eSpark-Backup/chrisanderson-tensiondevice/Deliverables/Renderings/3D-TopView.png

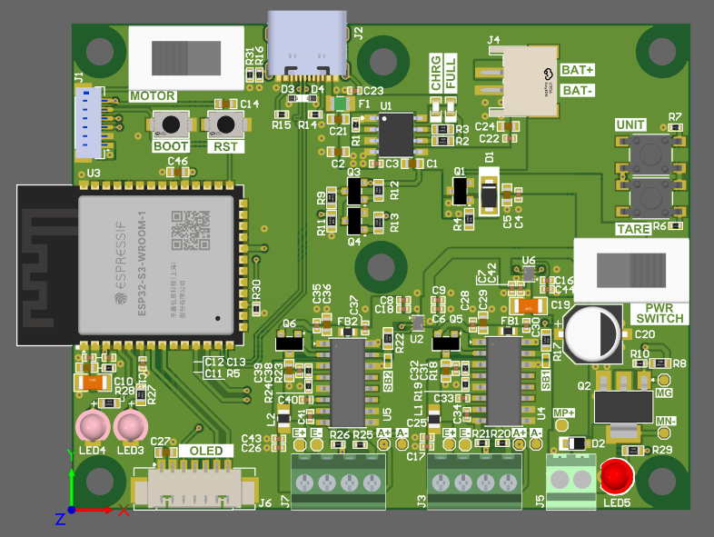
Deliverables/Renderings/3D-TopView.png
