eSpark-Backup/chrisanderson-tensiondevice/Deliverables/Renderings/Isometric.png

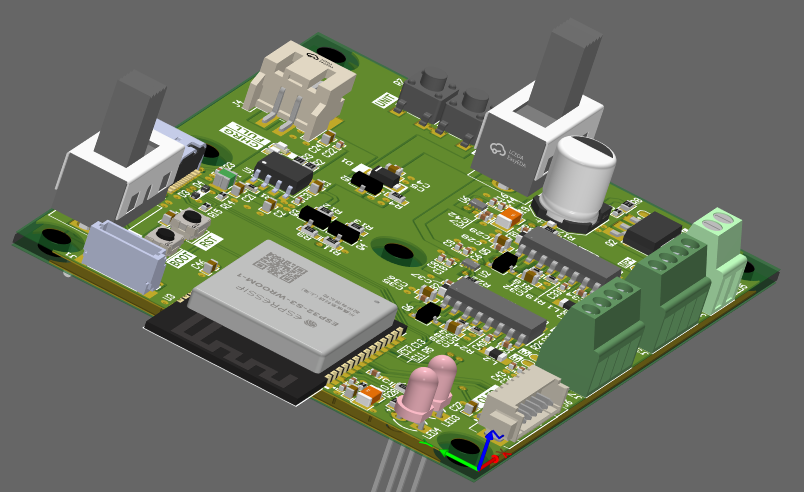
Deliverables/Renderings/Isometric.png
