eSpark-Backup/chrisanderson-tensiondevice/Deliverables/Renderings/2D-View.png

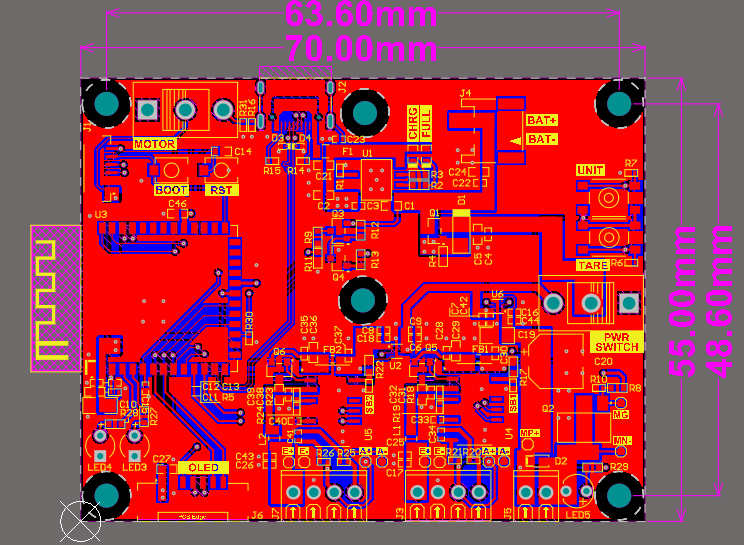
Deliverables/Renderings/2D-View.png
