eSpark-Backup/chrisanderson-tensiondevice/Deliverables/Renderings/3D-BottomView.png

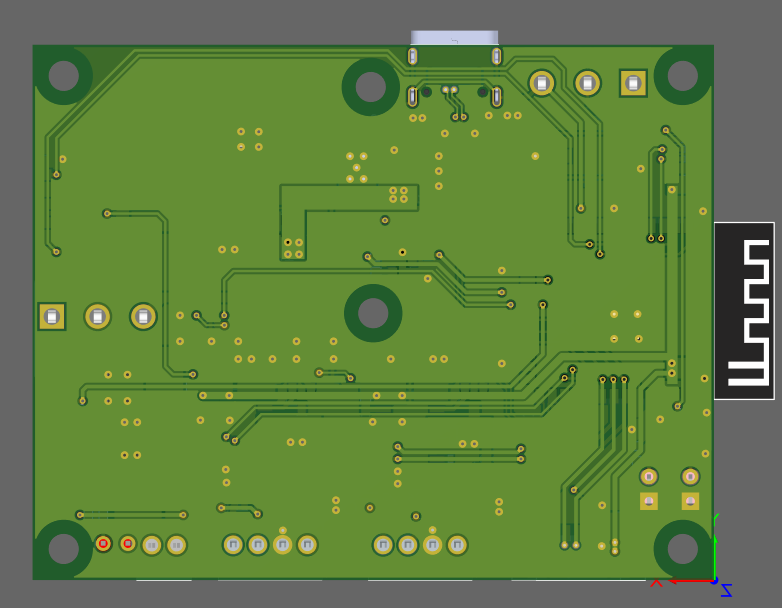
Deliverables/Renderings/3D-BottomView.png
