eSpark-Backup/chrisanderson-tensiondevice/Deliverables/BOM/Client BOM.xlsx

# | Item Type | Designator | Description | Footprint | Manufacturer Part Number | Manufacturer | Value | Quantity | Remarks
1 | Capacitor | C1, C2, C5, C21, C24, C27 | CAP CER 10UF 25V X5R 0603 | Cap-0603 | CL10A106MA8NRNC | Samsung | 10uF | 6
2 | Capacitor | C3, C12, C15, C22 | CAP CER 0.1UF 25V X5R 0402 | Cap-0402 | CC0402KRX5R8BB104 | Yageo | 100nF | 4
3 | Capacitor | C4 | CAP CER 0.1UF 50V X5R 0402 | Cap-0402 | C1005X5R1H104K050BB | TDK | 0.1uF | 1
4 | Capacitor | C6, C8, C42, C44 | CAP CER 2.2UF 25V X5R 0402 | Cap-0402 | GRM155R61E225KE11D | Murata | 2.2uF | 4
5 | Capacitor | C7, C9, C16, C18, C25, C43 | CAP CER 10UF 10V X5R 0402 | Cap-0402 | CC0402MRX5R6BB106 | Yageo | 10uF | 6
6 | Capacitor | C10, C19 | 10V 100uF X5R ±20% 1206 Multilayer Ceramic Capacitors MLCC - SMD/SMT ROHS | Cap-1206 | GRM31CR61A107ME05L | Murata | 100uF | 2
7 | Capacitor | C11 | CAP CER 22UF 10V X5R 0603 | Cap-0603 | CC0603MRX5R6BB226 | Yageo | 22uF | 1
8 | Capacitor | C13 | CAP CER 1UF 25V X5R 0402 | Cap-0402 | CC0402KRX5R8BB105 | Yageo | 1uF | 1
9 | Capacitor | C14, C46 | CAP CER 0.1UF 50V X5R 0603 | Cap-0603 | CC0603KRX5R9BB104 | Yageo | 100nF | 2
10 | Capacitor | C17, C26, C28, C30, C31, C33, C34, C35, C37, C38, C40, C41 | CAP CER 0.1UF 100V X5R 0402 | Cap-0402 | GRM155R62A104KE14D | Murata | 0.1uf | 12
11 | Capacitor | C20 | 470uF 10V 220mA@120Hz 450mΩ ±20% SMD,D6.3xL5.8mm Aluminum Electrolytic Capacitors - SMD ROHS | Custom | RVE1A471M0605 | Roqang | 470uF | 1
12 | Capacitor | C23 | CAP CER 4700PF 50V X7R 0402 | Cap-0402 | CC0402KRX7R9BB472 | Yageo | 4.7nF | 1
13 | Capacitor | C29, C32, C36, C39 | CAP CER 10UF 10V X5R 0603 | Cap-0603 | CC0603KRX5R6BB106 | Yageo | 10uF | 4
14 | Diode | D1 | SOD-123FL Schottky Barrier Diodes (SBD) ROHS | SOD-123FL | PMEG4030ER | Shikues | - | 1
15 | Diode | D2 | DIODE SCHOTTKY 40V 1A SOD323 | SOD-323 | B5819WS-TP | MDD | - | 1
16 | Diode | D3, D4 | TVS DIODE 5V 9.8V SOD923 | SOD-923. | ESD9L5.0ST5G | ON Semiconductor | - | 2
17 | Fuse | F1 | 6V 2A 50A 1W -40℃~+85℃ 4A 4mΩ 5s 45mΩ 0805 Resettable Fuses ROHS | Fuse-0805 | BSMD0805L-200 | BHFUSE | - | 1
18 | Ferrite Bead | FB1, FB2 | FERRITE BEAD 120 OHM 0603 1LN | IND-0603 (1608 Metric) | BLM18SG121TN1D | Murata | - | 2
19 | Connector | J1 | 1x6P SH 1 1mm 6 SMD,P=1mm Wire To Board / Wire To Wire Connector ROHS | Custom | C145963 | BOOMELE | - | 1
20 | USB Connector | J2 | 5A 1 16P Female Type-C SMD USB Connectors ROHS | Custom | TYPE-C-31-M-12 | Korean Hroparts Elec | - | 1
21 | Screw Terminal | J3, J7 | 1x4P 6A -40℃~+105℃ 150V Green 18~24 Direct Insert 2.54mm 1 1 4 Plugin,P=2.54mm Screw Terminal Blocks ROHS | Custom | MX128-2.54-04P-GN01-Cu-Y-A | MAX | - | 2
22 | Connectors | J4 | CONN HEADER SMD R/A 2POS 2MM | Custom | S2B-PH-SM4-TB(LF)(SN) | JST | - | 1
23 | Screw Terminal | J5 | 1x2P 6A -40℃~+105℃ 150V Green 18~24 Direct Insert 2.54mm 1 1 2 Plugin,P=2.54mm Screw Terminal Blocks ROHS | Custom | MX128-2.54-02P-GN01-Cu-Y-A | MAX | - | 1
24 | Wire to Board Connector | J6 | SMD,P=1.25mm,Surface Mount，Right Angle | Custom | 1.25-7PWT | FG | - | 1
25 | Inductor | L1, L2 | 800mA 3.3uH ±20% 0805 Power Inductors ROHS | Ind-0805 | CMH201209B3R3MT | FH (Guangdong Fenghua Advanced Tech) | 3.3uH | 2
26 | LED | LED1 | RED LED 0603 Light Emitting Diodes | LED-0603 | NCD0603R3 | Foshan NationStar Optoelectronics | - | 1
27 | LED | LED2 | Emerald 0603 Light Emitting Diodes (LED) ROHS | LED-0603 | NCD0603G2 | Foshan NationStar Optoelectronics | - | 1
28 | LED | LED3 | 515nm~525nm -30℃~+85℃ Emerald 30° 200mW Plugin,D=3mm Light Emitting Diodes (LED) ROHS | TH LED 3mm_ | NFD3401UGD | Foshan NationStar Optoelectronics | - | 1
29 | LED | LED4 | 20mA -40℃~+80℃ 605nm Amber Color 50° 3mm圆形灯头 75mW Plugin,D=3mm Light Emitting Diodes (LED) ROHS | TH LED 3mm_ | LTL17KFL5D-012A | Lite-On | - | 1
30 | LED | LED5 | 620nm~630nm -30℃~+85℃ Red 30° 200mW Plugin,D=3mm Light Emitting Diodes (LED) ROHS | TH LED Red 3MM | NFD3401URD | Foshan NationStar Optoelectronics | - | 1
31 | Mosfet | Q1 | 30V 7A 19mΩ 1.9W 1.1V@250uA P Channel SOT-23-3L MOSFETs ROHS | SOT-23-3L_ | G7P03L | GoFord | - | 1
32 | MOSFETs | Q2 | MOSFET N-CH 55V 12A SOT223 | SOT- 223 | BUK9832-55A/CUX | Nexperia | - | 1
33 | Mosfet | Q3 | 30V 4.1A 60mΩ@10V,4.1A 350mW 3V@250uA P Channel SOT-23 MOSFETs ROHS | SOT-23 | AO3407 | Guangdong Hottech | - | 1
34 | Mosfet | Q4 | TRANS NPN 40V 0.6A SMD SOT23-3 | SOT-23 | MMBT2222A-7-F | Diodes | - | 1
35 | Mosfet | Q5, Q6 | TRANS PNP 40V 600MA SOT23-3 | sot-23 | MMBT4403LT1G | ON Semiconductor | - | 2
36 | Resistor | R1 | RES 1.2K OHM 1% 1/16W 0402 | Res-0402 | RC0402FR-071K2L | Yageo | 1.2K | 1
37 | Resistor | R2, R3 | RES SMD 330R 100 mW 0603 | Res-0603 | RC0603JR-07330RL | Yageo | 330R | 2
38 | Resistor | R4 | RES 100K OHM 5% 1/10W 0603 | Res-0603 | RC0603JR-07100KL | Yageo | 100K | 1
39 | Resistor | R5, R10 | RES SMD 10K OHM 0.5% 1/16W 0402 | Res-0402 | RE0402DRE0710KL | Yageo | 10K | 2
40 | Resistor | R6, R7, R14, R15, R30, R31 | RES 5.1K OHM 1% 1/16W 0402 | Res-0402 | RC0402FR-075K1L | Yageo | 5.1K | 6
41 | Resistor | R8 | RES SMD 100 OHM 1% 1/4W 0603 | RES-0603 | RCA0603100RFKEAHP | Vishay Dale | 100R | 1
42 | Resistor | R9 | RES SMD 100K OHM 0.1% 1/10W 0603 | Res-0603 | RT0603BRD07100KL | Yageo | 100K | 1
43 | Resistor | R11 | RES 270K OHM 0.5% 1/10W 0603 | Res-0603 | RC0603DR-07270KL | Yageo | 270K | 1
44 | Resistor | R12, R13 | RES SMD 1K OHM 1% 1/10W 0603 | Res-0603 | RC0603FR-071KL | Yageo | 1K | 2
45 | Resistor | R16 | Res Thick Film 0402 1M Ohm 1% 0.1W(1/10W) ±100ppm/C Pad SMD Automotive T/R | Res-0402 | RK73H1ETTP1004F | KOA Speer | 1M | 1
46 | Resistor | R17, R22 | RES SMD 10K Ohm 1% 1/10W 0603 | Res-0603 | RC0603FR-0710KL | Yageo | 10K | 2
47 | Resistor | R18, R23 | RES SMD 20K OHM 0.1% 1/16W 0402 | Res-0402 | RT0402BRD0720KL | Yageo | 20K | 2
48 | Resistor | R19, R24 | RES SMD 8.2K OHM 0.1% 1/16W 0402 | Res-0402 | RT0402BRD078K2L | Yageo | 8.2K | 2
49 | Resistor | R20, R21, R25, R26 | RES 100 OHM 1% 1/16W 0402 | Res-0402 | RC0402FR-07100RL | Yageo | 100R | 4
50 | Resistor | R27, R28, R29 | RES 130 OHM 1% 1/10W 0603 | Res-0603 | RC0603FR-07130RL | Yageo | 130R | 3
51 | Switch | SW1, SW6 | 3A Direct Insert Single Pole Double Throw (SPDT) 125V Black 10,000 times Plugin Slide Switches ROHS | Custom |  | XKB Connectivity | - | 2
52 | Tactile Switch | SW2, SW3 | Without bracket 50mA 4mm 100000 Times 12V 160gf 3mm 2mm Round Button Standing paste SPST SMD Tactile Switches ROHS | Custom | TS-1088-AR02016 | XUNPU | - | 2
53 | Switch | SW4, SW5 | No NO 50mA 4.5mm 100000 260gf 12V -30℃~+85℃ 4.5mm 4.3mm Black Round Button Brick nogging SPST SMD Tactile Switches ROHS | Custom | TS-1109S-C-B | XKB Connectivity | - | 2
54 | IC | U1 | ESOP-8 Battery Management ICs ROHS | ESOP-8 | TP4056-42-ESOP8 | TOPPOWER | - | 1
55 | IC | U2, U6 | IC REG LINEAR 3.3V 1A 8DFN | DFN-8(1.2x1.6) | LD56100DPU33R | STMicroelectronics | - | 2
56 | Module | U3 | SMD MODULE, ESP32-S3R8 WITH 3.3V | 41-SMD Module | ESP32-S3-WROOM-1-N16R8 | Espressif Systems | - | 1
57 | IC | U4, U5 | 2.7V~5.5V 24Bit SOP-16 Analog to Digital Converters (ADC) ROHS | SOP-16 | HX711 | Avia Semicon (Xiamen) | - | 2
58 | Peripheral | - | 3v 101 RPM motor | - | DC Motor | - | - | 1 | Aliexpress (https://vi.aliexpress.com/item/1005006213184701.html?gatewayAdapt=4itemAdapt)
59 | Peripheral | - | 500gm Load cell without HX711 load cell IC module | - | Load Cell | - | - | 1 | Aliexpress (https://vi.aliexpress.com/item/1005006024363708.html)
60 | Peripheral | - | 2.42 inch White OLED | - | LED Module | - | - | 1 | Alibaba (https://www.alibaba.com/product-detail/Waveshare-2-42inch-OLED-Display-Module_1600969512051.html)
61 | Peripheral | - | 7 Pin 10cm Reverse Side Double head inter-connection cable | - | JST Cable | - | - | 1 | Aliexpress (https://vi.aliexpress.com/item/1005006120886981.html)
