eSpark-Backup/chrisanderson-tensiondevice/Deliverables/Supporting File/Thread Tension Gauge .step

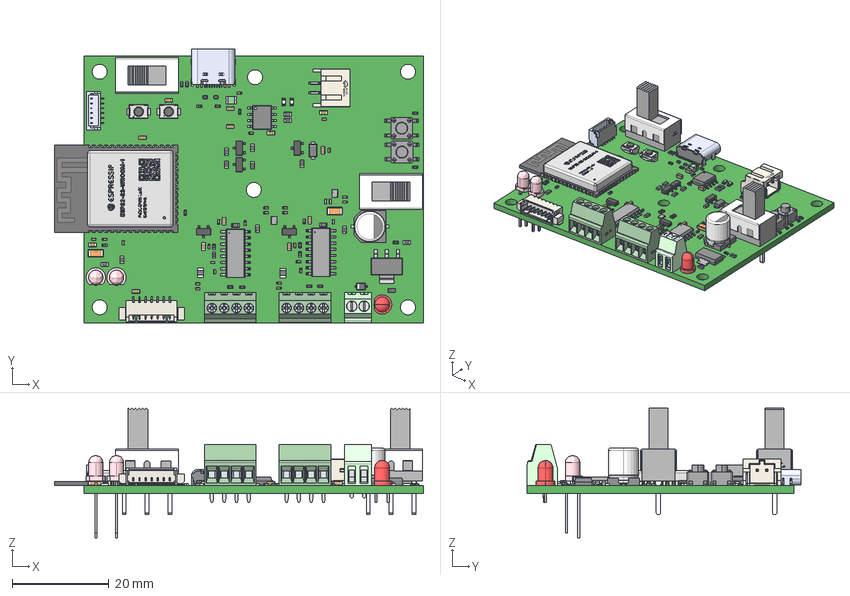
[picture p5: CAD file, 2025-05-21]
Deliverables/Supporting File/Thread Tension Gauge .step
76.1 x 56.5 x 26.8 mm
User Library-RESC1608X05N x 13
User Library-1206 SMD Capacitor x 2
User Library-DIODE_SOD-923 x 2
User Library-CAPC1608X09 x 13
User Library-SOD323-1
User Library-RES_1005-0402 x 18
User Library-Capacitor 0402 x 29
SO_18HDTR_STM x 2
ESP-S3-WROOM_via v3 x 26
ESP32-S3-WROOM_shell v11
ESP32-S3-WROOM_body v12
ESP-S3-WROOM_via v3(镜像) x 14
TP4056-42-ESOP8--3DModel-STEP-56544
ts-1109s-c-b_RGB6710886 x 2
CircuitWorks-SOT-23 x 5
User Library-SOT-223-1
User Library-LED 3 mm x 2
User Library-LED SMD0603 x 2
TYPE-C-31-M-12
SOLID.step.STEP.dwg.STEP.STEP.dwg
Lötende x 4
base x 2
User Library-fuse0805L050WR
User Library-SOD-123FL CASE 498
