eSpark-Backup/chrisanderson-tensiondevice/(list of files, cad)

Other CAD files:
Deliverables/Supporting File/Thread Tension Gauge .DWG
Deliverables/Supporting File/Thread Tension Gauge .DXF
