eSpark-Backup/chrisanderson-tensiondevice/Deliverables/Assembly Drawing/Thread Tension Gauge.pdf

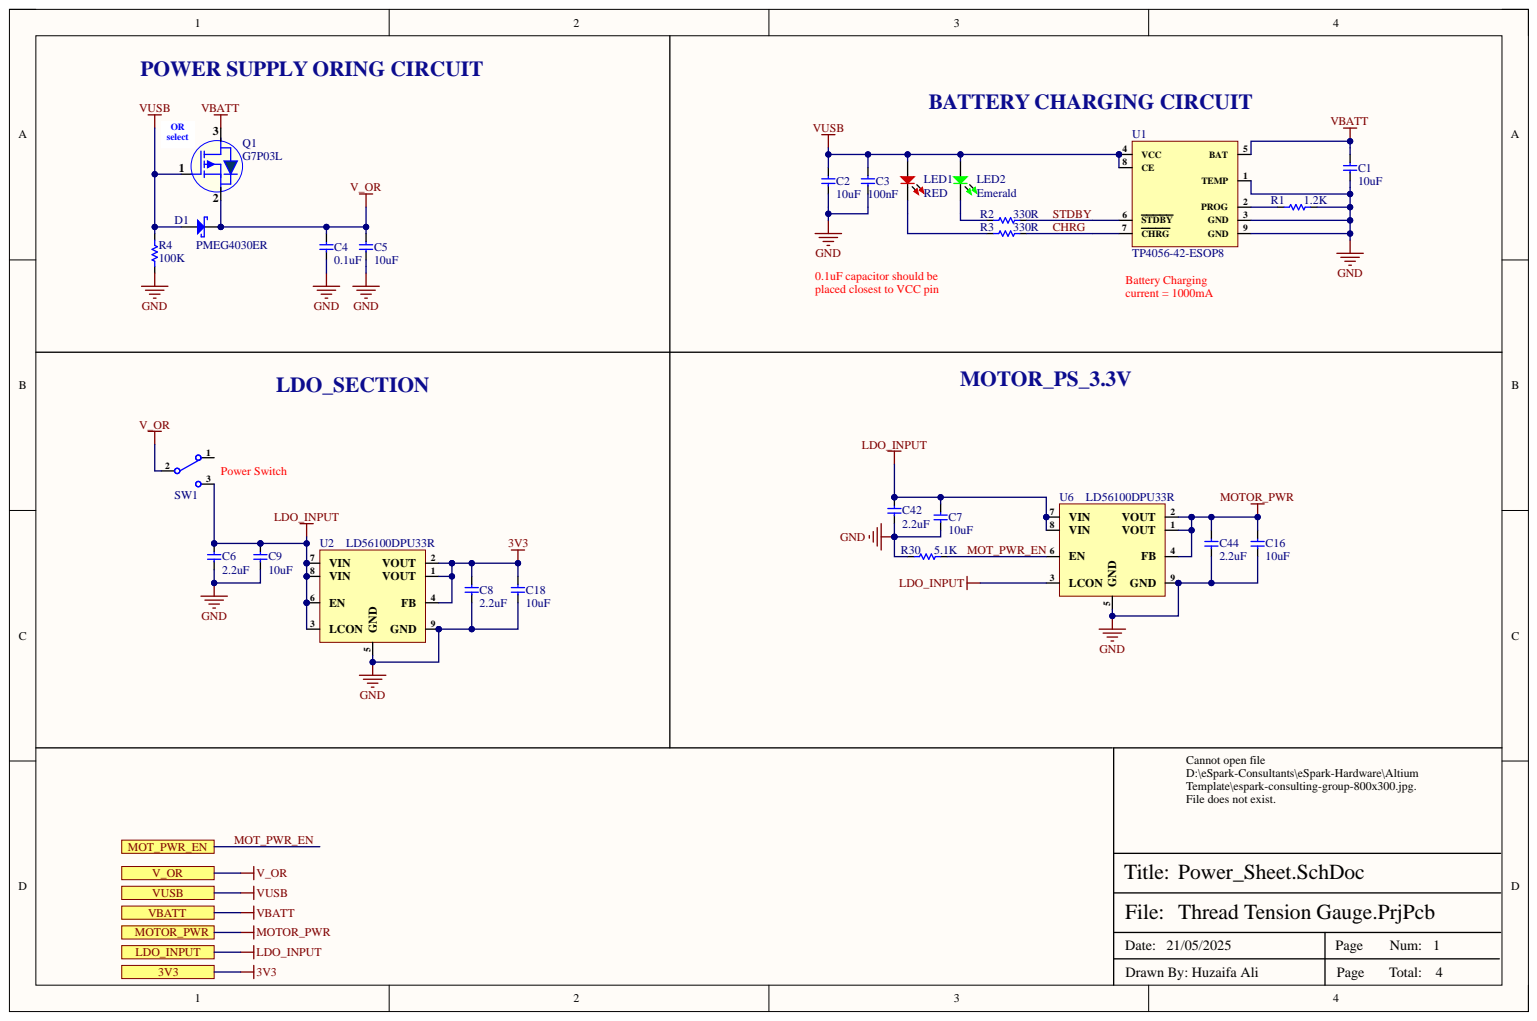
[picture p6: page 1]

POWER SUPPLY ORING CIRCUIT

0.1uF capacitor should be
placed closest to VCC pin

Cannot open file
D:\eSpark-Consultants\eSpark-Hardware\Altium
Template\espark-consulting-group-800x300.jpg.
File does not exist.

Thread Tension Gauge.PrjPcb

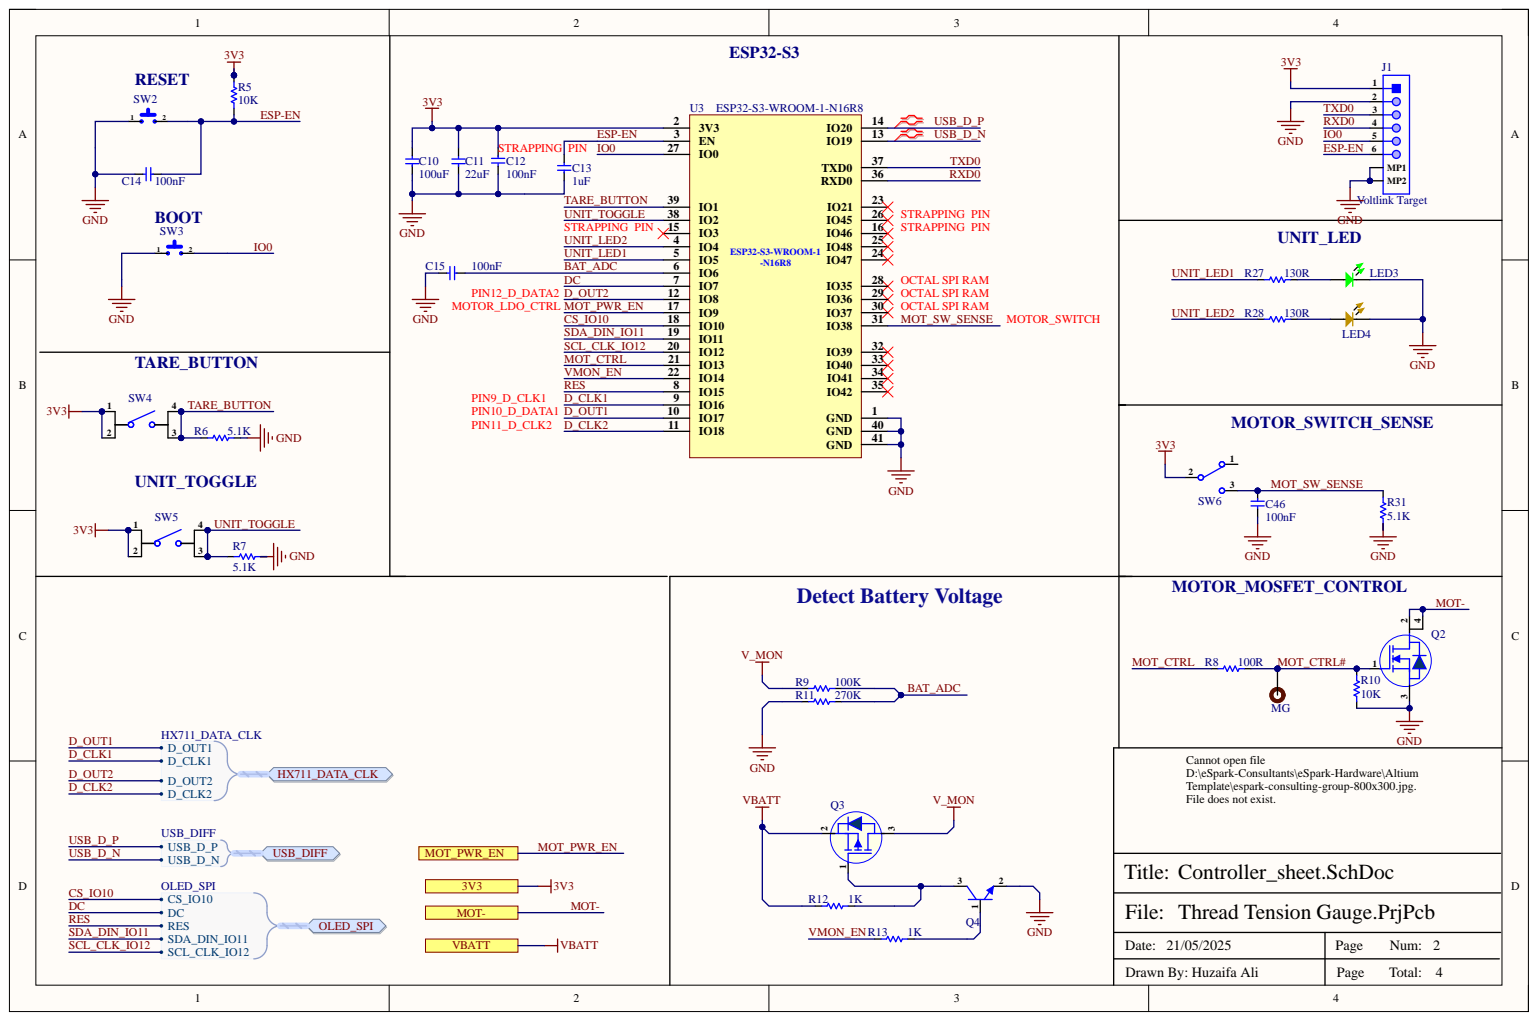
[picture p7: page 2]
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

Thread Tension Gauge.PrjPcb

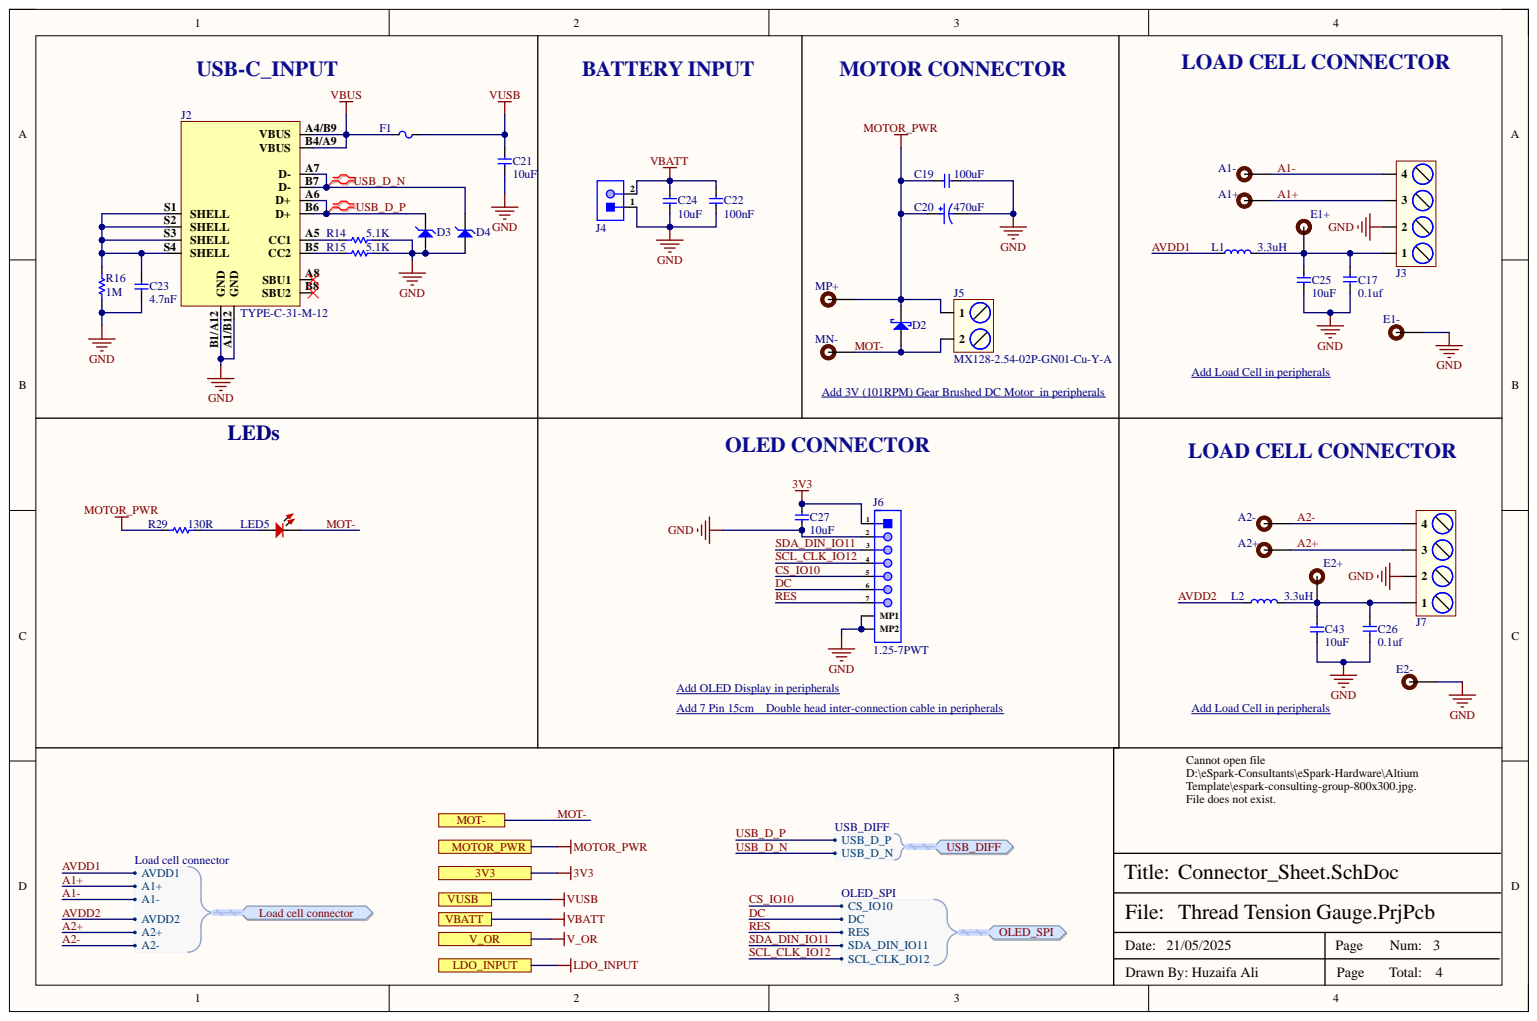
[picture p8: page 3]

Add Load Cell in peripherals

Add 3V (101RPM) Gear Brushed DC Motor in peripherals (https://vi.aliexpress.com/item/3256806026869949.html?gatewayAdapt=4itemAdapt)

Add OLED Display in peripherals (https://vi.aliexpress.com/item/3256805672655223.html?gatewayAdapt=glo2vnm4itemAdapt)
Add 7 Pin 15cm Double head inter-connection cable in peripherals (https://vi.aliexpress.com/i/2255800979562577.html?gatewayAdapt=glo2vnm4itemAdapt)

Add Load Cell in peripherals (https://vi.aliexpress.com/item/3256805838048956.html)

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

Thread Tension Gauge.PrjPcb

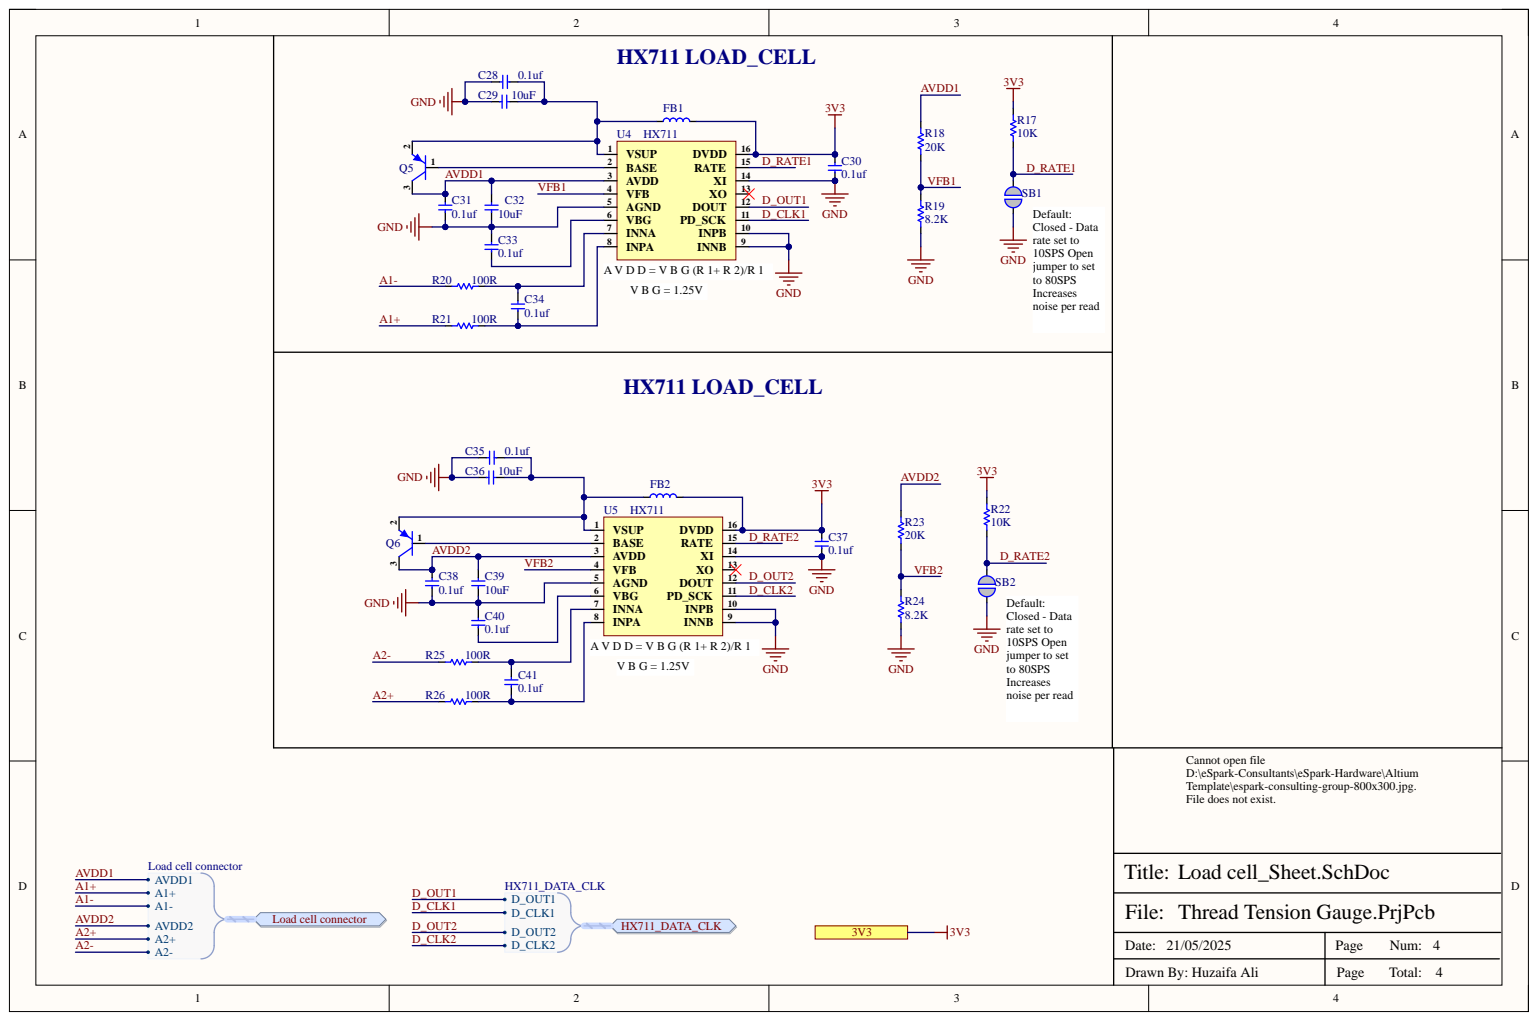
[picture p9: page 4]

C33
0.1uf

VFB2

C39
10uF

C40

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

Thread Tension Gauge.PrjPcb
