eSpark-Backup/chrisanderson-tensiondevice/Design Files/Tension Device/Schematic/Thread Tension Gauge.pdf

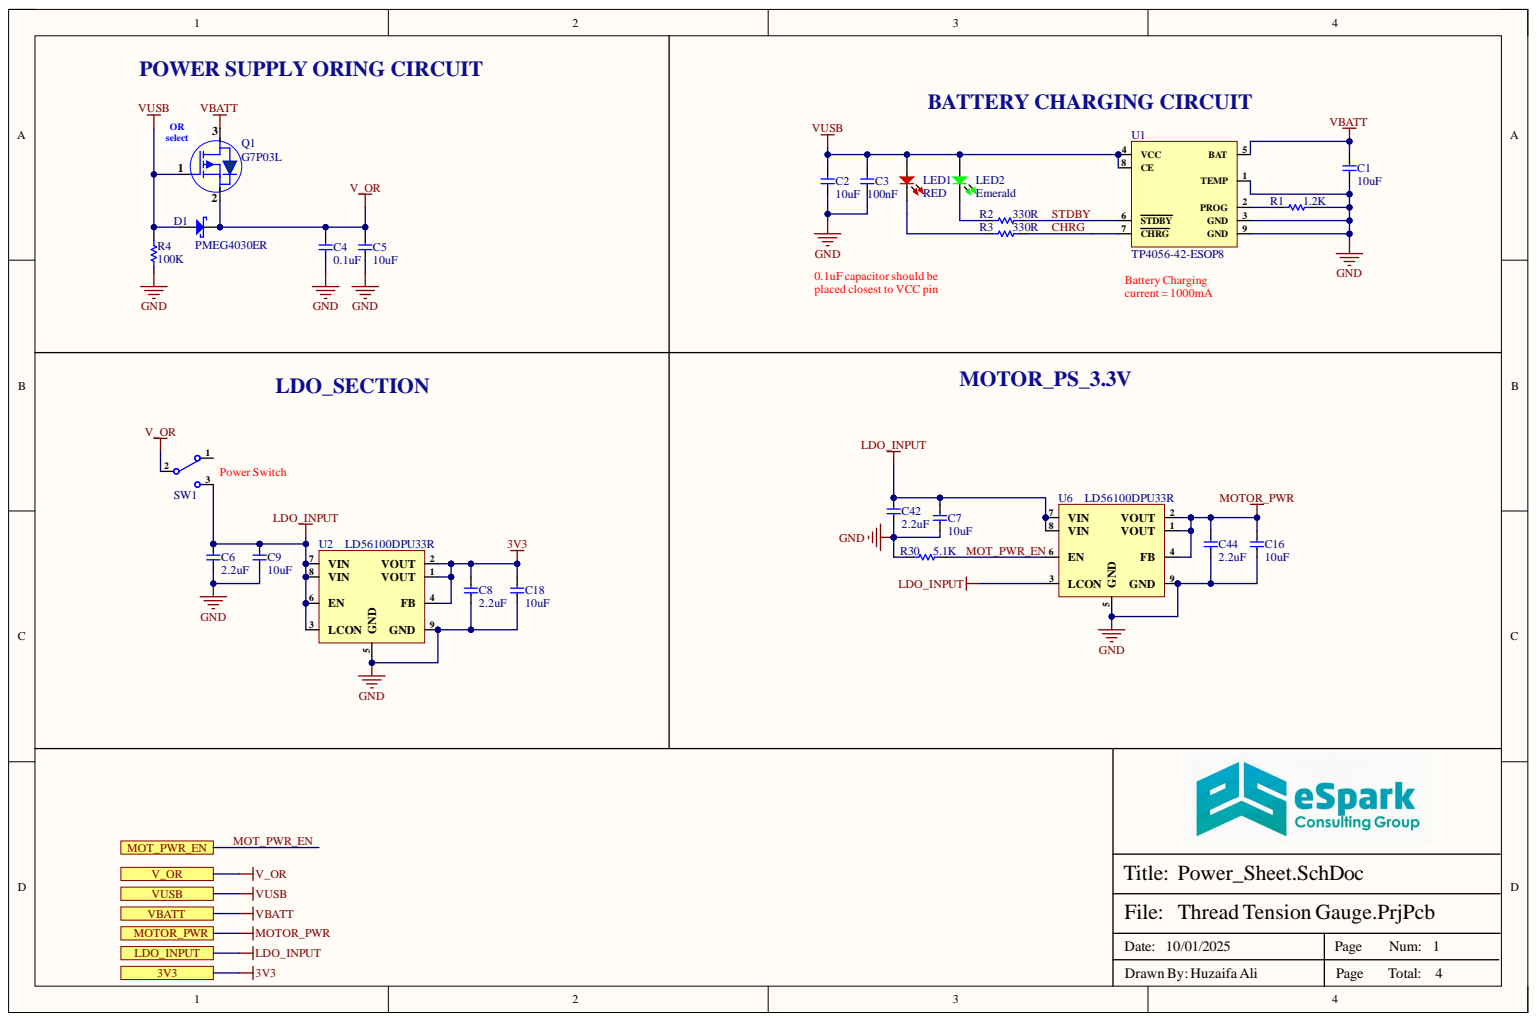
[picture p10: page 1]

POWER SUPPLY ORING CIRCUIT

0.1uF capacitor should be
placed closest to VCC pin

Thread Tension Gauge.PrjPcb

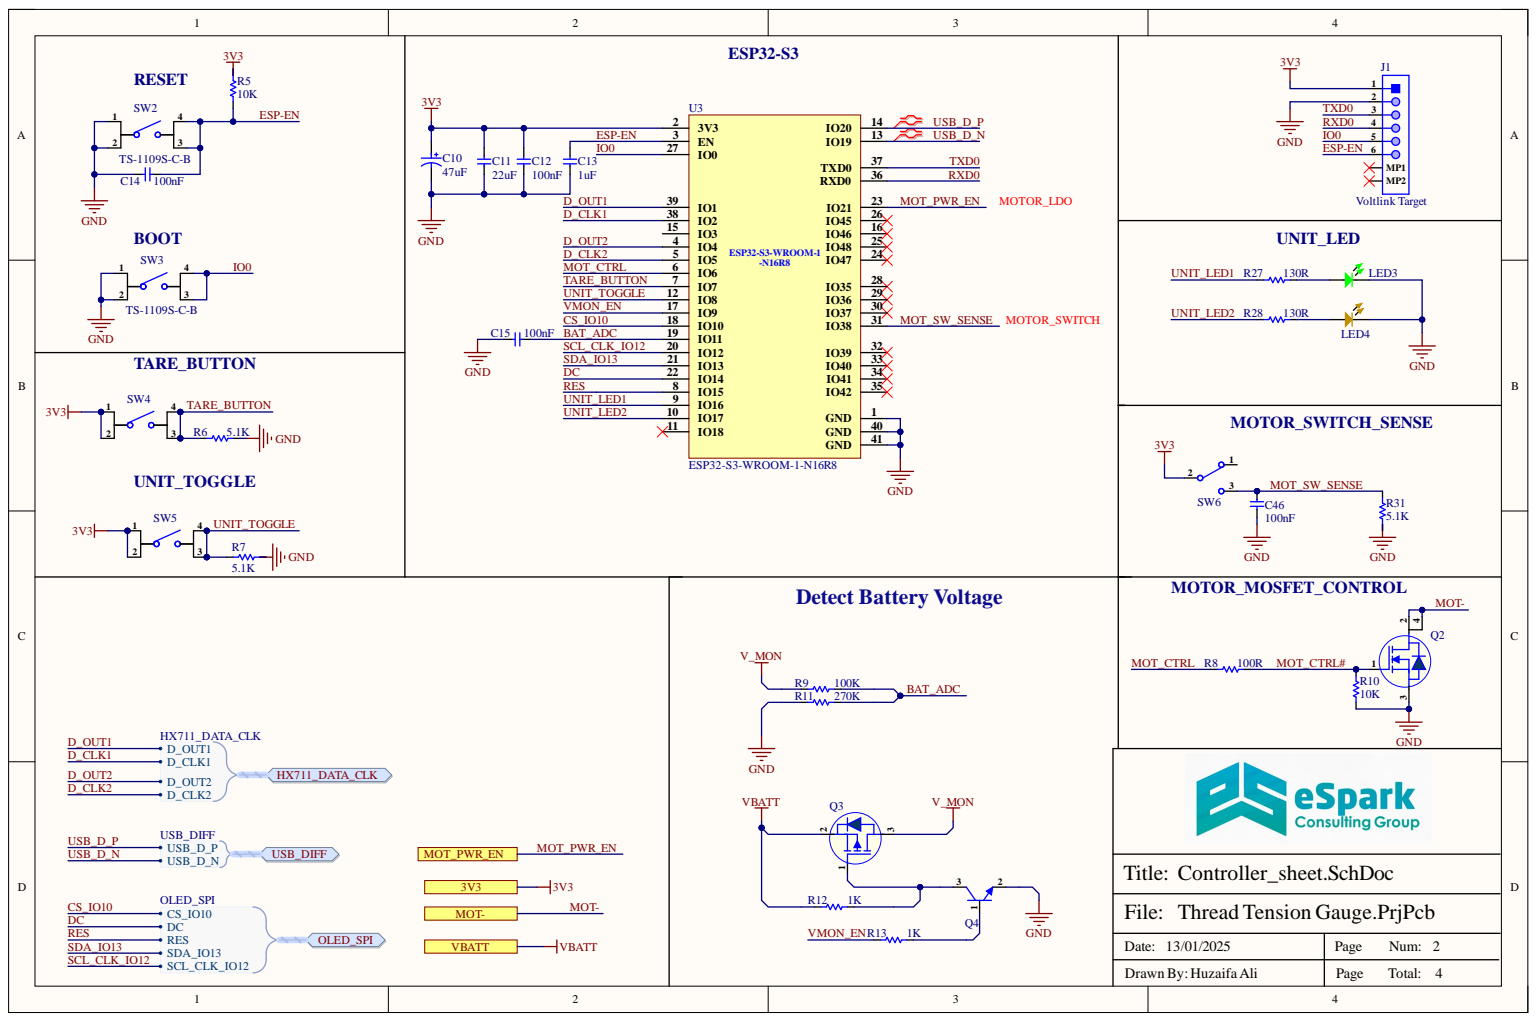
[picture p11: page 2]

Thread Tension Gauge.PrjPcb

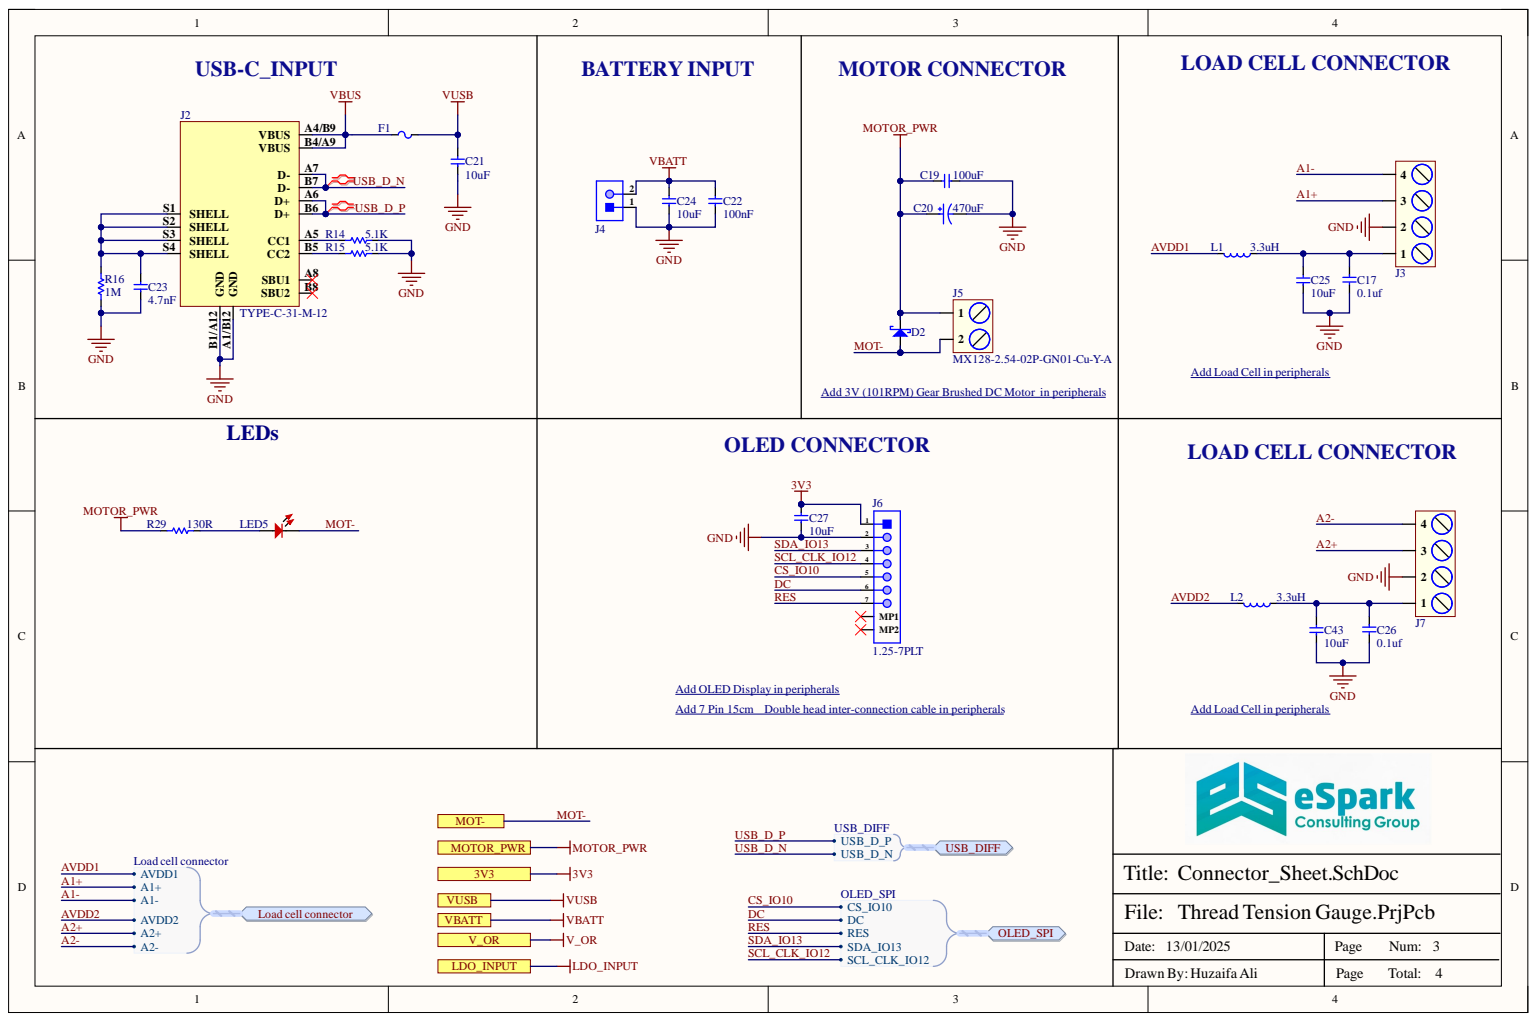
[picture p12: page 3]

Add Load Cell in peripherals

Add 3V (101RPM) Gear Brushed DC Motor in peripherals (https://vi.aliexpress.com/item/3256806026869949.html?gatewayAdapt=4itemAdapt)

Add OLED Display in peripherals (https://vi.aliexpress.com/item/3256805672655223.html?gatewayAdapt=glo2vnm4itemAdapt)
Add 7 Pin 15cm Double head inter-connection cable in peripherals (https://vi.aliexpress.com/i/2255800979562577.html?gatewayAdapt=glo2vnm4itemAdapt)

Add Load Cell in peripherals (https://vi.aliexpress.com/item/3256805838048956.html)

Thread Tension Gauge.PrjPcb

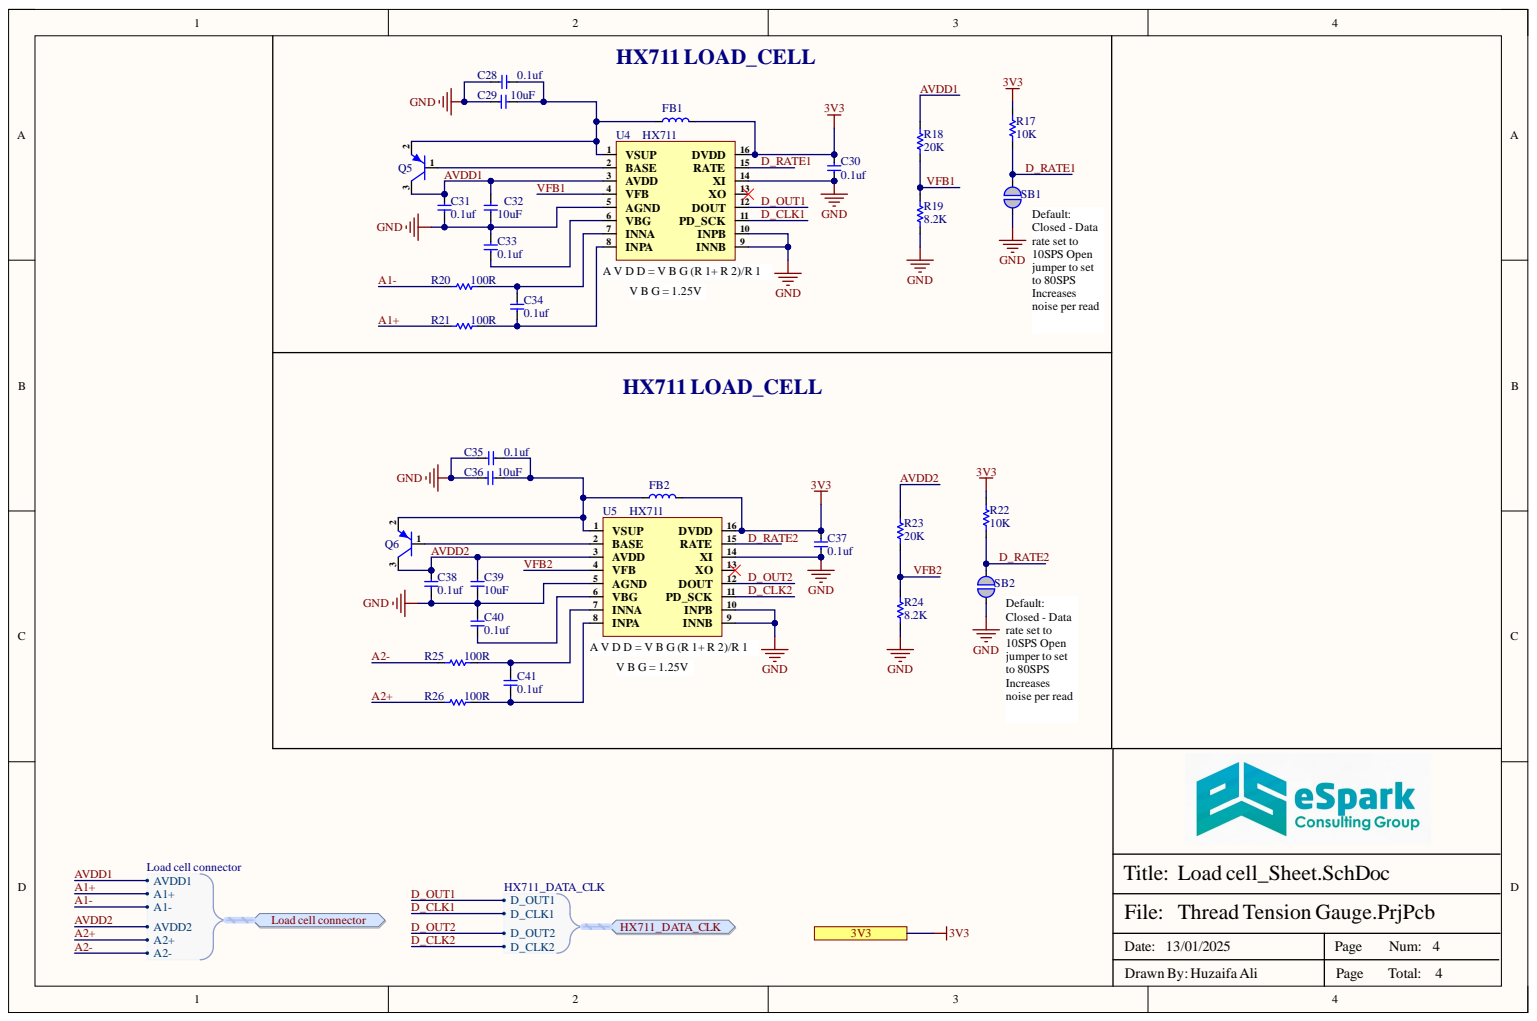
[picture p13: page 4]

C33
0.1uf

C40

Thread Tension Gauge.PrjPcb
