eSpark-Backup/chrisanderson-tensiondevice/Deliverables/Assembly Drawing/Assembly Drawing.pdf

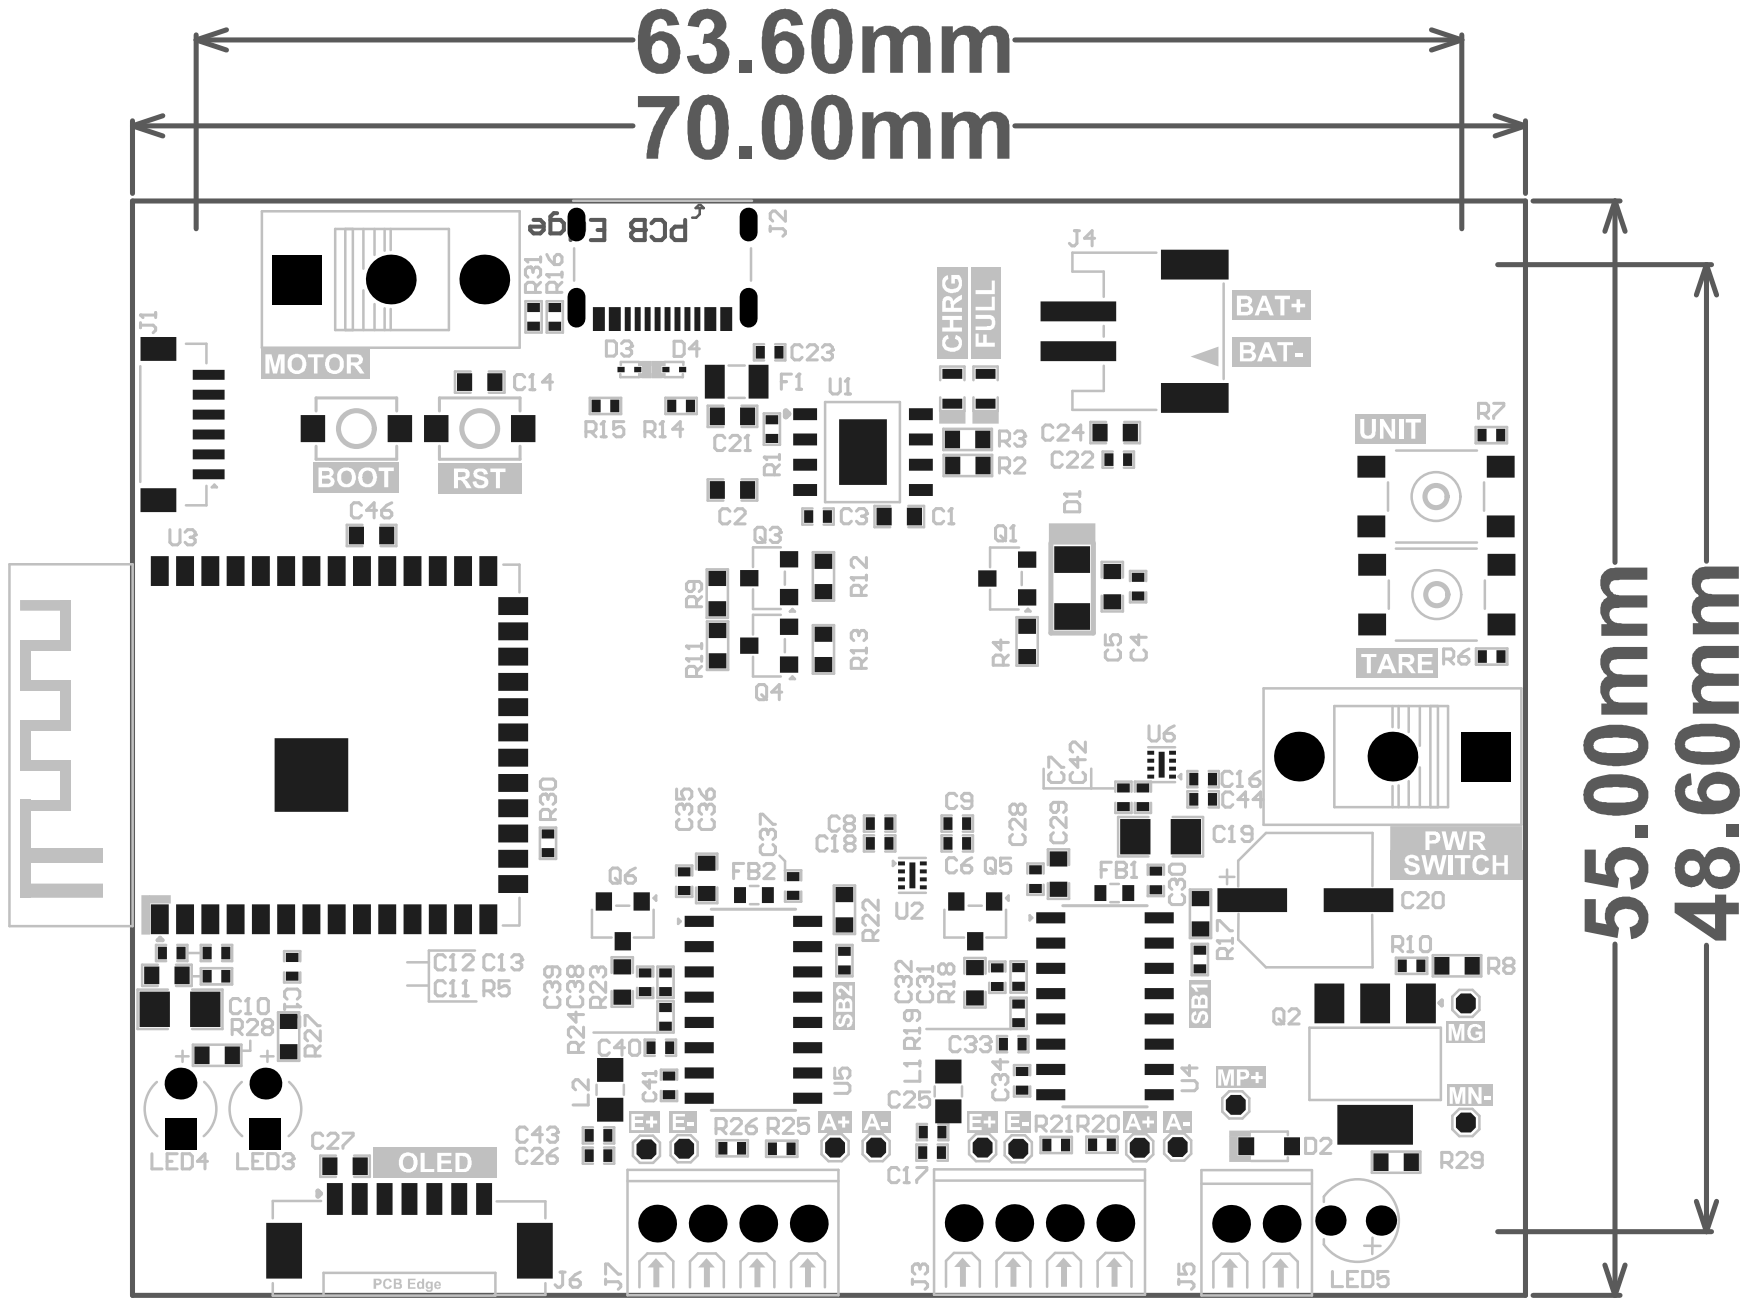
[picture p14: page 1]

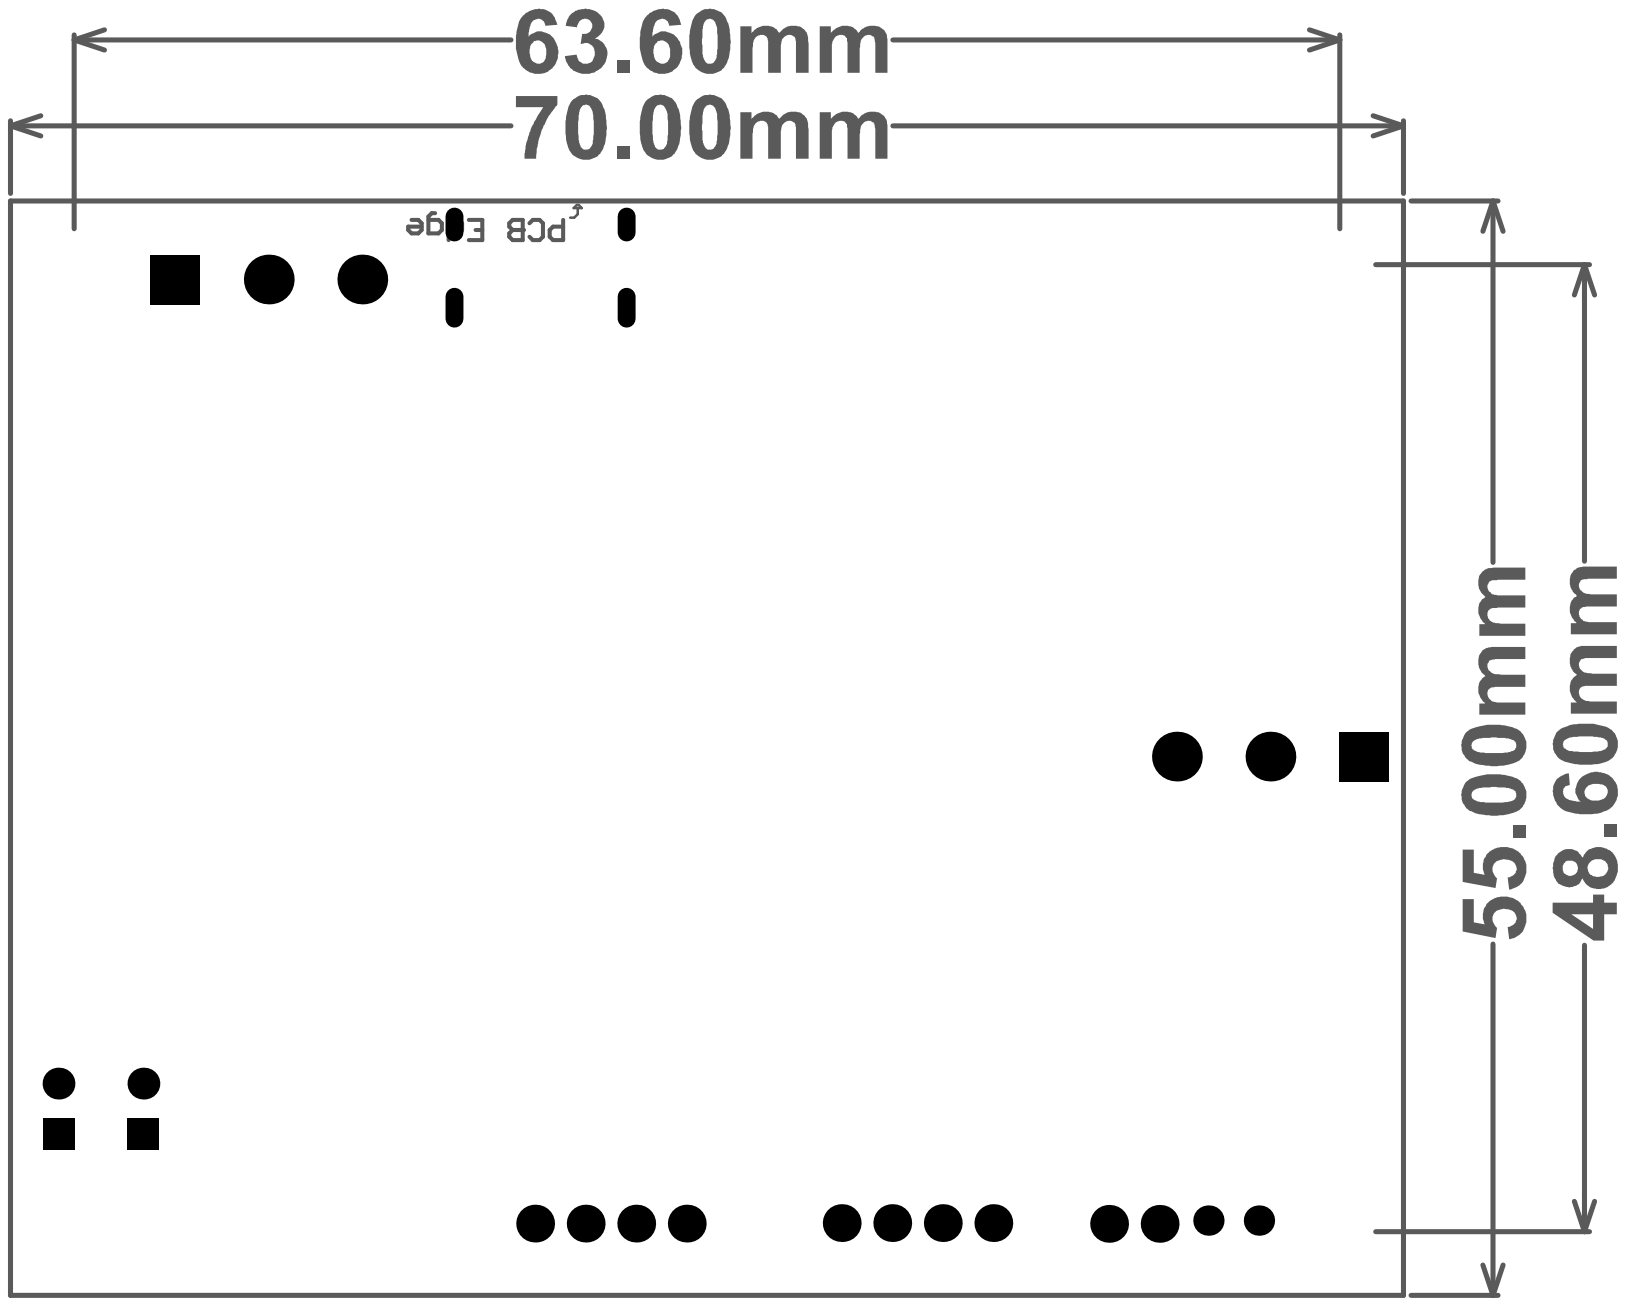
[picture p15: page 2]
