eSpark-Backup/chrisanderson-tensiondevice/(list of files, drawings)

Other design files:
Design Files/Tension Device/Connector_Sheet.SchDoc
Design Files/Tension Device/Controller_sheet.SchDoc
Design Files/Tension Device/Load cell_Sheet.SchDoc
Design Files/Tension Device/Power_Sheet.SchDoc
Design Files/Tension Device/Thread Tension Gauge .PcbDoc
Design Files/Tension Device/Thread Tension Gauge.PrjPcb
