eSpark-Backup/chrisanderson-tensiondevice/(commit log)

2025-01-01 #1 Added power sheet (in progress)
    [Poweer_Sheet.SchDoc, Tension Device.PrjPcb]
2025-01-02 #1 Updated Design (in progress)
    [Connector_Sheet.SchDoc, Controller_sheet.SchDoc, Load cell_Sheet.SchDoc, Poweer_Sheet.SchDoc, Tension Device.PrjPcb]
2025-01-03 #2 updated power,controller,connector and load cell schematic (in progress)
    [Connector_Sheet.SchDoc, Controller_sheet.SchDoc, Load cell_Sheet.SchDoc, Poweer_Sheet.SchDoc, Power_Sheet.SchDoc, Tension Device.PrjPcb]
2025-01-06 #2 Updated Power,controller, connector and load cell section
    [Connector_Sheet.SchDoc, Controller_sheet.SchDoc, Load cell_Sheet.SchDoc, Power_Sheet.SchDoc, Tension Device.PrjPcb]
2025-01-07 #2 Updated Schematic Design
    [Connector_Sheet.SchDoc, Controller_sheet.SchDoc, Load cell_Sheet.SchDoc, Power_Sheet.SchDoc]
2025-01-07 #2 Updated PCB (in progress)
    [Connector_Sheet.SchDoc, Load cell_Sheet.SchDoc, Tension Device.PrjPcb, Thread Tension Gauge.PcbDoc]
2025-01-07 Updated PCB Design ( in progress )
    [Connector_Sheet.SchDoc, Controller_sheet.SchDoc, Load cell_Sheet.SchDoc, Power_Sheet.SchDoc, Thread Tension Gauge.PcbDoc, Thread Tension Gauge.PrjPcb]
2025-01-08 #4 Updated PCB design
    [Connector_Sheet.SchDoc, Controller_sheet.SchDoc, Power_Sheet.SchDoc, Thread Tension Gauge .PcbDoc, Thread Tension Gauge.PrjPcb]
2025-01-08 updated Schematic design ( in progress)
    [Connector_Sheet.SchDoc, Controller_sheet.SchDoc, Load cell_Sheet.SchDoc, Power_Sheet.SchDoc]
2025-01-09 #3 Added DC motor peripheral link, (done)
    [Connector_Sheet.SchDoc, Thread Tension Gauge.PrjPcb]
2025-01-09 #4 Updated component placement (in progress)
    [Connector_Sheet.SchDoc, Controller_sheet.SchDoc, Load cell_Sheet.SchDoc, Power_Sheet.SchDoc, Thread Tension Gauge .PcbDoc]
2025-01-10 #4 updated PCB Design (In progress)
    [Controller_sheet.SchDoc, Power_Sheet.SchDoc, Thread Tension Gauge .PcbDoc]
2025-01-13 #4 Updated PCB Design, Added Peripheral Links, updated PDF (PCB changes in progress)
    [Connector_Sheet.SchDoc, Load cell_Sheet.SchDoc, Thread Tension Gauge .PcbDoc]
2025-01-14 #2 updated PCB Design (in progress )
    [Connector_Sheet.SchDoc, Controller_sheet.SchDoc, Thread Tension Gauge .PcbDoc]
2025-01-15 #4 Updated PCB design (in progress)
    [Connector_Sheet.SchDoc, Controller_sheet.SchDoc, Thread Tension Gauge .PcbDoc, Thread Tension Gauge.PcbDoc]
2025-01-21 #4 Updated PCB design ( in progress )
    [Connector_Sheet.SchDoc, Controller_sheet.SchDoc, Power_Sheet.SchDoc, Thread Tension Gauge .PcbDoc]
2025-01-21 #4 Updated PCB design ( in progress)
    [Connector_Sheet.SchDoc, Controller_sheet.SchDoc, Thread Tension Gauge .PcbDoc, Thread Tension Gauge.PrjPcb]
2025-01-22 #4 updated PCB design (done)
    [Thread Tension Gauge .PcbDoc]
2025-02-13 #6 Necessary changes made and deliverables generated
    [Centroid.csv, Connector_Sheet.SchDoc, Pick Place for Thread Tension Gauge .csv, Thread Tension Gauge .DWG, Thread Tension Gauge .DXF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]
2025-02-13 #5 Order Placed Client and JLCPCB BOM added with peripherals.
    [Client BOM.xlsx, JLCPCB-BOM.xlsx]
2025-04-03 #8 Tested PCB various parameters (in progress)
2025-05-08 #9 Resolve few issues most of them is on pending
    These issues has been resolved.
    1- Connect and initialize OLED display.
    2- Display the battery percentage.
    3- Display readings for both load cells.
    4- Toggle motor ON/OFF via a button.
    5- Control a 5V DC motor through a GPIO or PWM signal.
    6- Ensure constant speed control logic is in place.
    7- Motor ON/OFF toggle button.
    8- Read the battery voltage through ADC.
    9- Convert the voltage to battery percentage.
    [Battery.cpp, Battery.hpp, DEV_Config.h, Dual_LoadCell_Serial_test_code.ino, Firmware.ino]
2025-05-12 #9 Switching Unite (miliForce) to (gramForce)
2025-05-14 #9 Add changes in BMS , implementations of Web Page, and switching Mode
2025-05-14 #9 Add Auto Calibration when press unit toggle and tare press together.
2025-05-15 #9 add changes in battery monitoring
2025-05-15 #9 add implementation of calibration display on screen
2025-05-20 Client BOM updated with the correct Dupont cable
    [Client BOM.xlsx]
2025-05-21 #4 Updated PCB design ( Battery voltage sense pin updated)
    [Controller_sheet.SchDoc, Thread Tension Gauge .PcbDoc, Thread Tension Gauge.PrjPcb]
2025-05-21 #4 Deliverables generated
    [Centroid.csv, Pick Place for Thread Tension Gauge .csv, Thread Tension Gauge .DWG, Thread Tension Gauge .DXF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]
